njalooo/valetudo-dreameadapter/pcbs/dreamebreakout-usb_c/kicad/DreameBreakout.kicad_pcb

## KiCad design pcbs/dreamebreakout-usb_c/kicad/DreameBreakout.kicad_pcb (2024-08-05)

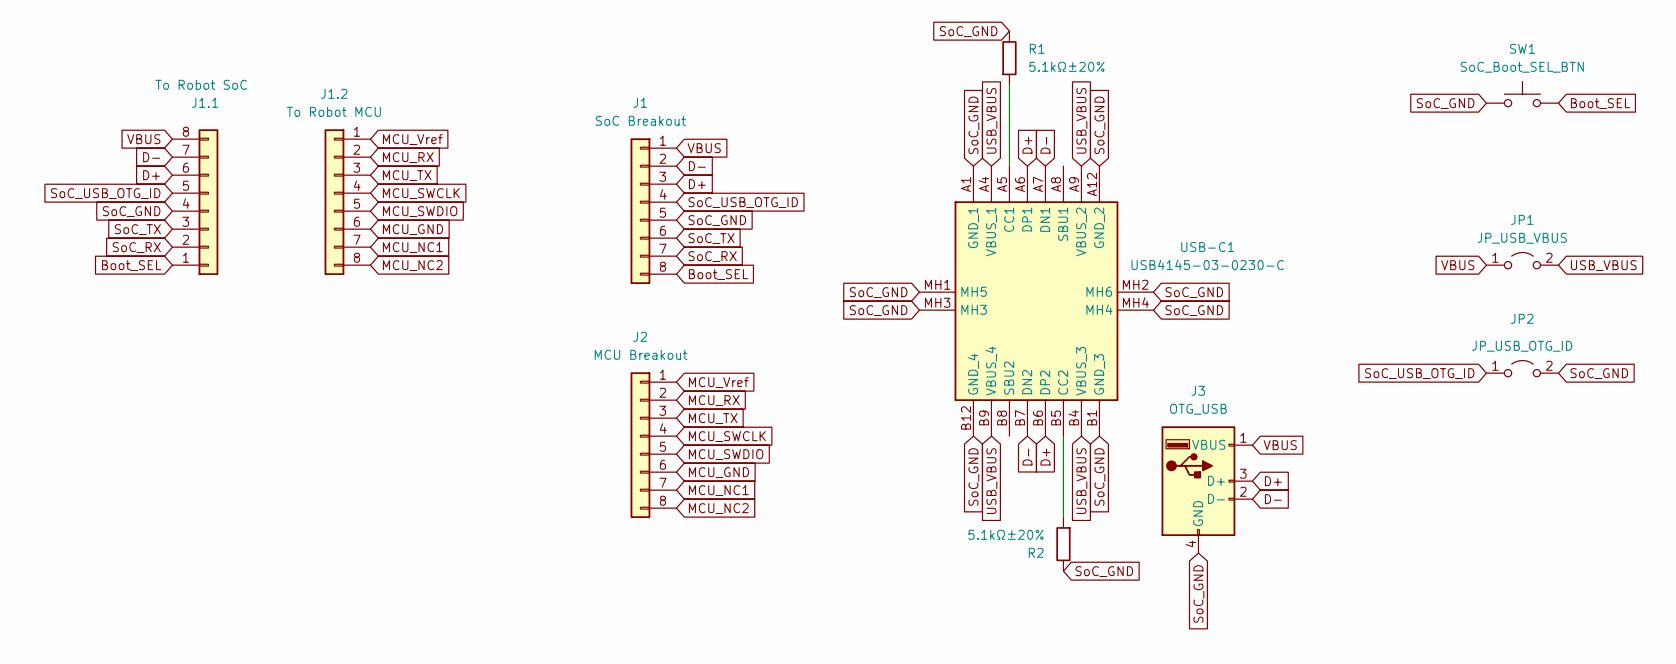
[picture p15: schematic DreameBreakout.kicad_sch]

Parts:
J1: SoC Breakout; PinSocket_1x08_P2.54mm_Vertical
J1.1: To Robot SoC; DGI_8_SMDPADS
J1.2: To Robot MCU; DGI_8_SMDPADS
J2: MCU Breakout; PinSocket_1x08_P2.54mm_Vertical
J3: OTG_USB; ONSHORE_USB-A1VSB6
JP1: JP_USB_VBUS; PinSocket_1x02_P2.00mm_Vertical
JP2: JP_USB_OTG_ID; PinSocket_1x02_P2.00mm_Vertical
R1, R2: 5.1kΩ±20%; R_Axial_DIN0204_L3.6mm_D1.6mm_P7.62mm_Horizontal
SW1: SoC_Boot_SEL_BTN; SW_PUSH_6mm
USB-C1: USB4145-03-0230-C; USB4145030230C; Mouser Part Number 640-USB4145-3-0230-C

Connections:
Boot_SEL: J1.8, J1.1.1, SW1.2
D+: J1.3, J1.1.6, J3.3 (D+), USB-C1.A6 (DP1), USB-C1.B6 (DP2)
D-: J1.2, J1.1.7, J3.2 (D-), USB-C1.A7 (DN1), USB-C1.B7 (DN2)
MCU_GND: J1.2.6, J2.6
MCU_NC1: J1.2.7, J2.7
MCU_NC2: J1.2.8, J2.8
MCU_RX: J1.2.2, J2.2
MCU_SWCLK: J1.2.4, J2.4
MCU_SWDIO: J1.2.5, J2.5
MCU_TX: J1.2.3, J2.3
MCU_Vref: J1.2.1, J2.1
unnamed: R1.1, USB-C1.A5 (CC1)
unnamed: R2.1, USB-C1.B5 (CC2)
SoC_GND: J1.5, J1.1.4, J3.4 (GND), JP2.2 (B), R1.2, R2.2, SW1.1, USB-C1.A1 (GND_1), USB-C1.A12 (GND_2), USB-C1.B1 (GND_3), USB-C1.B12 (GND_4), USB-C1.MH1 (MH5), USB-C1.MH2 (MH6), USB-C1.MH3, USB-C1.MH4
SoC_RX: J1.7, J1.1.2
SoC_TX: J1.6, J1.1.3
SoC_USB_OTG_ID: J1.4, J1.1.5, JP2.1 (A)
USB_VBUS: JP1.2 (B), USB-C1.A4 (VBUS_1), USB-C1.A9 (VBUS_2), USB-C1.B4 (VBUS_3), USB-C1.B9 (VBUS_4)
VBUS: J1.1, J1.1.8, J3.1 (VBUS), JP1.1 (A)

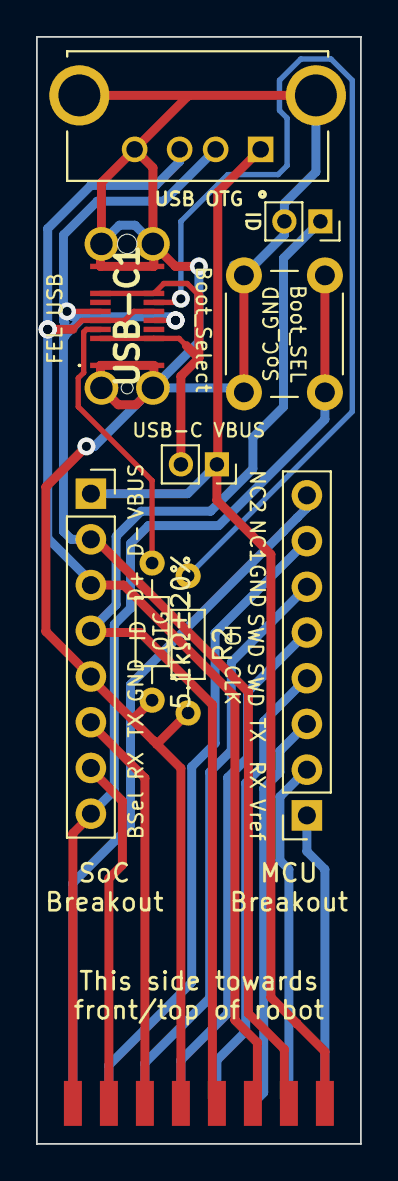
[picture p16: board DreameBreakout.kicad_pcb from above]

Board: 2 copper layers, 18.0 x 61.5 mm, 11 parts (1 on the bottom side), 19 nets.
