njalooo/valetudo-dreameadapter/(commit log)

2024-08-05 Replaced micro-USB with USB-C port
    [DreameBreakout.kicad_pcb, DreameBreakout.kicad_sch]
2024-08-05 Replaced micro-USB with USB-C receptacle. Also added a second Resistor for symeptric pluggablility
    [DreameBreakout.kicad_pcb, DreameBreakout.kicad_sch]
